Ganghyeok-Lim/Proj-STM32H743VIT6-Test-Dev-Board/Rev_A/03_Document/00_Project/Block Diagram/Block diagram.pptx

DC Barrel Jack

DC/DC Converter
1. P24VS → P5VS
2. P5VS → P3.3VS

SW & KEYPAD

Temperature Sensor
(LM75AD)

IR Sensor
(LTOP-ML38ATH)

STM32H743VIT6
(ARM Cortex-M7)

USB-UART
(CP2102)

EEPROM
AT24C16C

USB C-type

TFT LCD
(TFT-32A)

Character LCD
(OTM 651 Y-YG-1)

Buzzer

ADC
(ADS1100)

DAC
(MCP4725)

Ext. Header

## Slide 2

STM32H743VIT6

DC/DC Converter
1. P24VS → P5VS
2. P5VS → P3.3VS

SW & KEYPAD

CP2102
USB-UART

DC/DC Converters
1. +1V
2. +1.35V
3. +1.8V
4. +3.3V
5. VTT

USB C-type

Page. 5

DC Barrel Jack

Temperature Sensor

Page. 3

ADC

Page. 8,9

Mezzanine

Page. 10

Mezzanine

Page. 10
