Ganghyeok-Lim/Proj-STM32H743VIT6-Test-Dev-Board/Rev_A/01_HW/JLCPCB Fab data/4. Confirmation File/Part placement confirmation Image_240208_2223.png

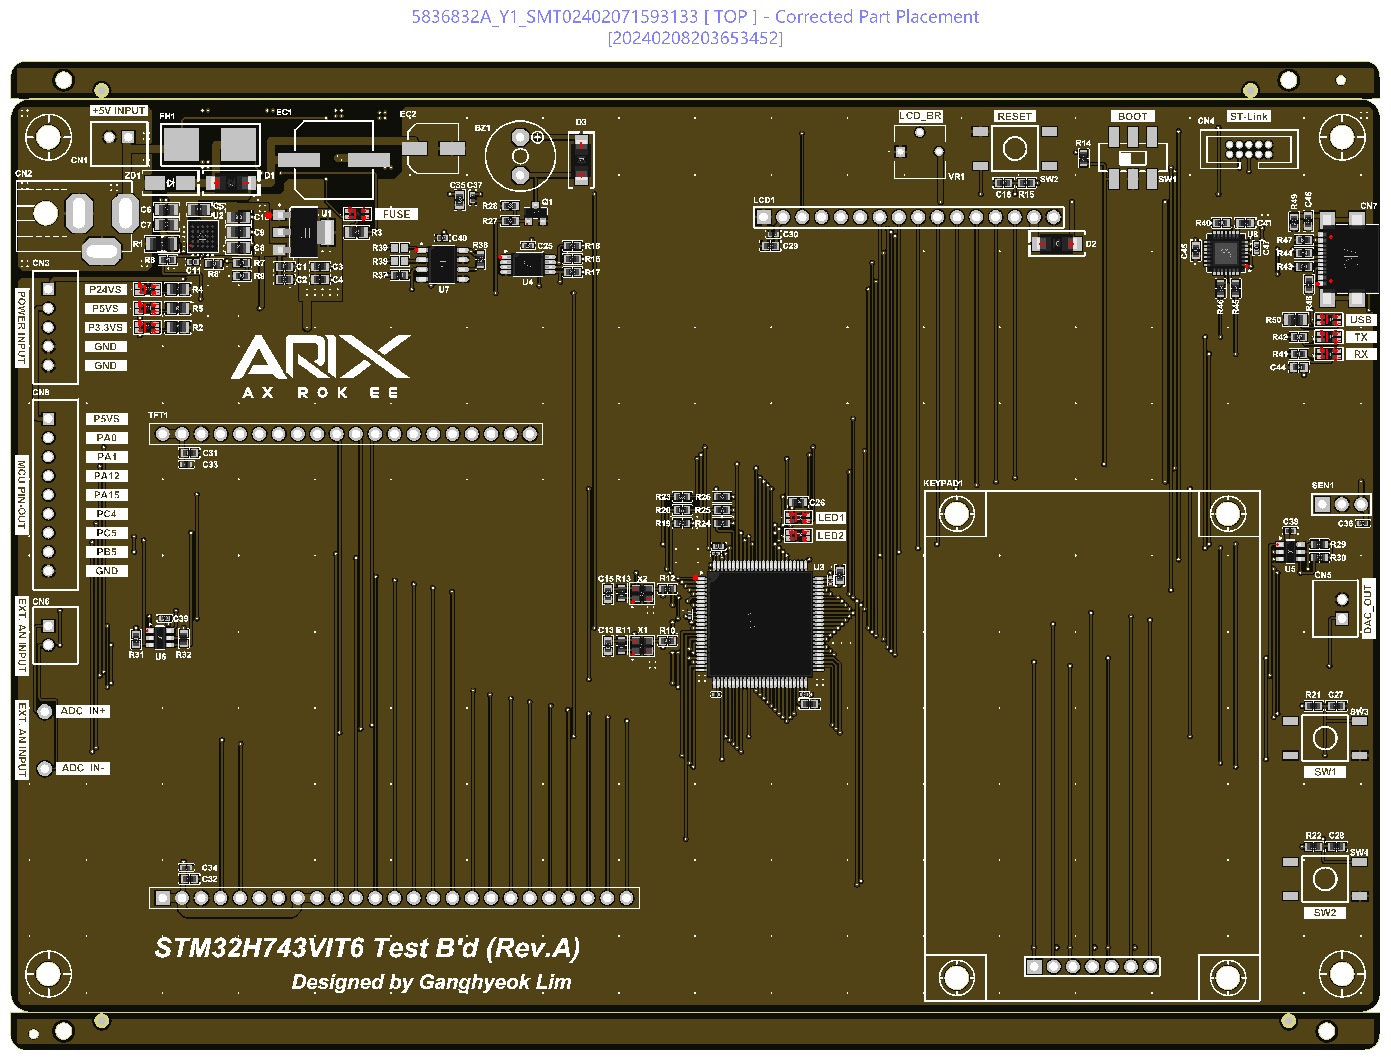
Rev_A/01_HW/JLCPCB Fab data/4. Confirmation File/Part placement confirmation Image_240208_2223.png
