Ganghyeok-Lim/Proj-STM32H743VIT6-Test-Dev-Board/Rev_A/01_HW/JLCPCB Fab data/2. BOM/Bill of Materials-STM32H743VIT6_Test_Bd.xlsx

Comment | Designator | Footprint | Quantity | LCSC Part #
FQ-014 | BZ1 | BUZ FQ-013 | 1
10uF/10V/1608 | C1, C4, C29, C31, C32, C35 | CAP 1608 (0603_INCH) | 6 | C19702
100nF/50V/1608 | C2, C3, C13, C15, C16, C27, C28, C46 | CAP 1608 (0603_INCH) | 8 | C14663
10uF/50V/2012 | C5, C10 | CAP 2012 (0805_INCH) | 2 | C440198
2.2uF/50V/2012 | C6, C9 | CAP 2012 (0805_INCH) | 2 | C49217
100nF/50V/2012 | C7, C8 | CAP 2012 (0805_INCH) | 2 | C49678
100nF/16V/1005 | C11, C25, C30, C33, C34, C36, C37, C38, C39, C40, C47 | CAP 1005 (0402_INCH) | 11 | C1525
15pF/16V/1608/NC | C12, C14, C42, C43 | CAP 1608 (0603_INCH)/NC | 4
4.7uF/10V/1005 | C17 | CAP 1005 (0402_INCH) | 1 | C23733
100nF/25V/0603 | C18, C19, C20, C21, C22 | CAP 0603 (0201_INCH) | 5 | C181047
2.2uF/16V/1608 | C23, C24, C26, C44 | CAP 1608 (0603_INCH) | 4 | C23630
1uF/50V/1608 | C41, C45 | CAP 1608 (0603_INCH) | 2 | C15849
0353120260 | CN1, CN5, CN6 | CON 0353120260 (MOLEX) | 3
DC_Jack | CN2 | CON DC-Jack | 1
0353120560 | CN3 | CON 0353120560 (MOLEX) | 1
3220-10-0100-00 | CN4 | CON 3220-10-0100-00 (Hand_Solder) | 1
MC-311S | CN7 | CON USB-Type-C (16P) | 1 | C2977718
0353120960 | CN8 | CON 0353120960 (MOLEX) | 1
SS34 | D1 | DIO DO-214AC (SMA) | 1 | C8678
M7 | D2, D3 | DIO DO-214AC (SMA) | 2 | C95872
330uF/35V/10Øx10 | EC1 | CAP ALSMD 10.3MM H10.5MM LEADSPANMAX12MM | 1 | C311621
100uF/35V/6.3Øx7.7 | EC2 | CAP ALSMD 6.6MM H7.7MM | 1 | C176666
01550900M | FH1 | FUSE 01550900M_SMD(Hand_Solder) | 1 | C108518
NTH-3MM | H1, H2, H3, H4 | HOLE NTH-3MM | 4
NT-804AN-BW | KEYPAD1 | KEYPAD_NT-804AN-BW | 1
Character_LCD(1602) | LCD1 | LCD_CHARACTOR-1602 | 1
BLUE/2012 | LED1, LED2, LED4, LED7, LED8, LED9 | LED MHT170RGBCT (BLUE) | 6 | C2962094
RED/2012 | LED3 | LED MHT170RGBCT (RED) | 1 | C2962094
RGB/2012 | LED5, LED6 | LED MHT170RGBCT | 2 | C2962094
MMBT3904 | Q1 | SOT 23-3 (DIODES INCORPORATED) | 1 | C20526
0R/3216 | R1 | RES 3216 (1206_inch) | 1 | C17888
330R/2012 | R2 | RES 2012 (0805_inch) | 1 | C17630
4.7K/2012 | R3, R4 | RES 2012 (0805_inch) | 2 | C17673
680R/2012 | R5, R50 | RES 2012 (0805_inch) | 2 | C17798
100K/1608 | R6, R14, R15, R21, R22 | RES 1608 (0603_inch) | 5 | C25803
47K/1608 | R7 | RES 1608 (0603_inch) | 1 | C25819
23.7K/1608 | R8 | RES 1608 (0603_inch) | 1 | C294653
300R/1608 | R9 | RES 1608 (0603_inch) | 1 | C23025
0R/1608 | R10, R11, R12, R13, R36, R43, R44, R45, R46 | RES 1608 (0603_inch) | 9 | C21189
4.7K/1608 | R16, R17, R18, R28, R29, R30, R31, R32, R40 | RES 1608 (0603_inch) | 9 | C23162
470R/1608 | R19, R20, R23, R24, R25, R26 | RES 1608 (0603_inch) | 6 | C23179
1K/1608 | R27 | RES 1608 (0603_inch) | 1 | C21190
4.7K/1608/NC | R33, R34, R35, R38, R39 | RES 1608 (0603_inch)/NC | 5
10K/1608 | R37 | RES 1608 (0603_inch) | 1 | C25804
330R/1608 | R41, R42 | RES 1608 (0603_inch) | 2 | C23138
5.1K/1608 | R47, R48 | RES 1608 (0603_inch) | 2 | C23186
1M/1608/0.1W | R49 | RES 1608 (0603_inch) | 1 | C22935
SB | SB1, SB2, SB3, SB4, SB5, SB6 | SB (Solder-Bridge) | 6
LTOP-ML38ATH | SEN1 | SEN_IR-LTOP-ML38ATH | 1
YSS-1201S(2mm)_2P | SW1 | SW YSS-1201S-2mm | 1
TACT_SW | SW2, SW3, SW4 | SW K2-1102SP-C4SC-04 | 3 | C127509
TFT-32A | TFT1 | LCD_TFT-32A | 1
TP_HOLE(1MM) | TP1, TP2 | TP_HOLE(1MM) | 2
AMS1117-3.3 | U1 | SOT 223-3 (DIODES INCORPORATED) | 1 | C6186
LTM8074IY#PBF | U2 | IC_BGA-25 | 1 | C690772
STM32H743VIT6 | U3 | LQFP-100_14x14MM (ST) | 1 | C114409
AT24C16 | U4 | TSSOP-8_PW (TI) | 1 | C112954
MCP4725A1T-E/CH | U5 | SOT-23-6 (TI DBV PACKAGE) | 1 | C61423
ADS1100A0IDBVR | U6 | SOT-23-6 (TI DBV PACKAGE) | 1 | C23361
LM75AD | U7 | SOIC-8 150mil Wide (MICRO CHIP) | 1 | C7963
CP2102-GMR | U8 | QFN-28 (5x5mm) | 1 | C6568
3362P-1-103LF | VR1 | VR_3362P-1-103LF | 1 | C58159
S2D12.000000B20F30T(12MHz) | X1 | OSC SMD_2.5x2.0 (SCTF) | 1 | C387449
S2D32.768KB20F30T(32.768kHz) | X2 | OSC SMD_2.5x2.0 (SCTF) | 1 | C387463
SMAJ24A | ZD1 | DIO DO-214AC (SMA) | 1 | C113962
