Ganghyeok-Lim/Proj-STM32H743VIT6-Test-Dev-Board/(list of files, drawings)

Other design files:
Rev_A/01_HW/STM32H743VIT6 Test B'd/00_Index.SchDoc
Rev_A/01_HW/STM32H743VIT6 Test B'd/01_Overview.SchDoc
Rev_A/01_HW/STM32H743VIT6 Test B'd/02_Power.SchDoc
Rev_A/01_HW/STM32H743VIT6 Test B'd/03_MCU.SchDoc
Rev_A/01_HW/STM32H743VIT6 Test B'd/04_LCD.SchDoc
Rev_A/01_HW/STM32H743VIT6 Test B'd/05_Sensor_Keypad.SchDoc
Rev_A/01_HW/STM32H743VIT6 Test B'd/06_Communication.SchDoc
Rev_A/01_HW/STM32H743VIT6 Test B'd/STM32H743VIT6 Test B'd.PrjPcb
