Ganghyeok-Lim/Proj-STM32H743VIT6-Test-Dev-Board/Rev_A/02_FW/STM32H743VIT6_Dev_Bd/Core/Src/main.c

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
/* Includes ------------------------------------------------------------------*/
#include "main.h"


TIM_HandleTypeDef htim1;
TIM_HandleTypeDef htim6;

/* USER CODE BEGIN PV */
uint8_t str1[] = "Live like Woong";
uint8_t str2[] = "     by Minjung";

extern uint8_t Keypad_value;
extern uint8_t Keypad_read_enable;
extern uint8_t Keypad_Data[32];
/* USER CODE END PV */

void SystemClock_Config(void);
static void MX_GPIO_Init(void);
static void MX_TIM1_Init(void);
static void MX_TIM6_Init(void);
/* USER CODE BEGIN PFP */
void Delay_us(uint16_t time_us);
/* USER CODE END PFP */

/**
  * @brief  The application entry point.
  * @retval int
  */
int main(void)
{
  /* MCU Configuration--------------------------------------------------------*/

  /* Reset of all peripherals, Initializes the Flash interface and the Systick. */
  HAL_Init();

  /* Configure the system clock */
  SystemClock_Config();

  /* Initialize all configured peripherals */
  MX_GPIO_Init();
  MX_TIM1_Init();
  MX_TIM6_Init();
  /* USER CODE BEGIN 2 */
	HAL_TIM_Base_Start(&htim1);
	HAL_TIM_Base_Start_IT(&htim6);

	HAL_GPIO_WritePin(MCU_KEYPAD_ROW1_GPIO_Port, MCU_KEYPAD_ROW1_Pin, LOW);

	HAL_Delay(10);
	Initialize_LCD();
	HAL_Delay(100);

	memset(Keypad_Data, 0x20, sizeof(Keypad_Data));





  /* USER CODE END 2 */

  /* Infinite loop */
  /* USER CODE BEGIN WHILE */
  while (1)
  {
    /* USER CODE END WHILE */

    /* USER CODE BEGIN 3 */
//	LCD_String(0x80, str1);
//	HAL_Delay(10);
//	LCD_String(0xC0, str2);
//	HAL_Delay(200);

//	LCD_Cursor(1,1);
//	LCD_Data(Keypad_value);
//	HAL_Delay(100);


	  for(int i = 0; i < 32; i++)
	  {
		  if(i < 16)
		  {
			  LCD_Cursor(1,i+1);
			  LCD_Data(Keypad_Data[i]);
			  HAL_Delay(1);
		  }
		  else
		  {
			  LCD_Cursor(2,i-15);
			  LCD_Data(Keypad_Data[i]);
			  HAL_Delay(1);
		  }
	  }

	  HAL_Delay(10);
  }
  /* USER CODE END 3 */
}

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
/* USER CODE BEGIN 4 */
void Delay_us(uint16_t time_us)
{
	__HAL_TIM_SET_COUNTER(&htim1, 0);
	while((__HAL_TIM_GET_COUNTER(&htim1))<time_us);
}

/* USER CODE END 4 */
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
