Ganghyeok-Lim/Proj-STM32H743VIT6-Test-Dev-Board/Rev_A/02_FW/STM32H743VIT6_Dev_Bd/Core/Inc/main.h

#define MCU_TACT_SW1_Pin GPIO_PIN_0
#define MCU_TACT_SW1_GPIO_Port GPIOC
#define MCU_TACT_SW1_EXTI_IRQn EXTI0_IRQn
#define MCU_TACT_SW2_Pin GPIO_PIN_1
#define MCU_TACT_SW2_GPIO_Port GPIOC
#define MCU_TACT_SW2_EXTI_IRQn EXTI1_IRQn
#define MCU_LED1_BLUE_Pin GPIO_PIN_0
#define MCU_LED1_BLUE_GPIO_Port GPIOB
#define MCU_LED1_GREEN_Pin GPIO_PIN_2
#define MCU_LED1_GREEN_GPIO_Port GPIOB
#define MCU_LED2_RED_Pin GPIO_PIN_12
#define MCU_LED2_RED_GPIO_Port GPIOB
#define MCU_CHAR_LCD_RS_Pin GPIO_PIN_8
#define MCU_CHAR_LCD_RS_GPIO_Port GPIOD
#define MCU_CHAR_LCD_RW_Pin GPIO_PIN_9
#define MCU_CHAR_LCD_RW_GPIO_Port GPIOD
#define MCU_CHAR_LCD_E_Pin GPIO_PIN_10
#define MCU_CHAR_LCD_E_GPIO_Port GPIOD
#define MCU_KEYPAD_ROW1_Pin GPIO_PIN_6
#define MCU_KEYPAD_ROW1_GPIO_Port GPIOC
#define MCU_KEYPAD_ROW2_Pin GPIO_PIN_7
#define MCU_KEYPAD_ROW2_GPIO_Port GPIOC
#define MCU_KEYPAD_ROW3_Pin GPIO_PIN_8
#define MCU_KEYPAD_ROW3_GPIO_Port GPIOC
#define MCU_KEYPAD_ROW4_Pin GPIO_PIN_9
#define MCU_KEYPAD_ROW4_GPIO_Port GPIOC
#define MCU_KEYPAD_COL1_Pin GPIO_PIN_10
#define MCU_KEYPAD_COL1_GPIO_Port GPIOC
#define MCU_KEYPAD_COL1_EXTI_IRQn EXTI15_10_IRQn
#define MCU_KEYPAD_COL2_Pin GPIO_PIN_11
#define MCU_KEYPAD_COL2_GPIO_Port GPIOC
#define MCU_KEYPAD_COL2_EXTI_IRQn EXTI15_10_IRQn
#define MCU_KEYPAD_COL3_Pin GPIO_PIN_12
#define MCU_KEYPAD_COL3_GPIO_Port GPIOC
#define MCU_KEYPAD_COL3_EXTI_IRQn EXTI15_10_IRQn
#define MCU_CHAR_LCD_DATA0_Pin GPIO_PIN_0
#define MCU_CHAR_LCD_DATA0_GPIO_Port GPIOD
#define MCU_CHAR_LCD_DATA1_Pin GPIO_PIN_1
#define MCU_CHAR_LCD_DATA1_GPIO_Port GPIOD
#define MCU_CHAR_LCD_DATA2_Pin GPIO_PIN_2
#define MCU_CHAR_LCD_DATA2_GPIO_Port GPIOD
#define MCU_CHAR_LCD_DATA3_Pin GPIO_PIN_3
#define MCU_CHAR_LCD_DATA3_GPIO_Port GPIOD
#define MCU_CHAR_LCD_DATA4_Pin GPIO_PIN_4
#define MCU_CHAR_LCD_DATA4_GPIO_Port GPIOD
#define MCU_CHAR_LCD_DATA5_Pin GPIO_PIN_5
#define MCU_CHAR_LCD_DATA5_GPIO_Port GPIOD
#define MCU_CHAR_LCD_DATA6_Pin GPIO_PIN_6
#define MCU_CHAR_LCD_DATA6_GPIO_Port GPIOD
#define MCU_CHAR_LCD_DATA7_Pin GPIO_PIN_7
#define MCU_CHAR_LCD_DATA7_GPIO_Port GPIOD
#define MCU_LED1_RED_Pin GPIO_PIN_4
#define MCU_LED1_RED_GPIO_Port GPIOB
#define MCU_LED2_BLUE_Pin GPIO_PIN_8
#define MCU_LED2_BLUE_GPIO_Port GPIOB
#define MCU_LED2_GREEN_Pin GPIO_PIN_9
#define MCU_LED2_GREEN_GPIO_Port GPIOB
#define FLAG				uint8_t
#define HIGH                (1U)
#define LOW                 (0U)
#define CLEAR				(0U)
#define ON					(1U)
#define OFF					(0U)
#define LOCK				(0U)
#define RELEASE				(1U)
#define KEY_PRESSED			(0U)
#define KEY_RELEASED		(1U)
#define KEYPAD_ROW1			1
#define KEYPAD_ROW2			2
#define KEYPAD_ROW3			3
#define KEYPAD_ROW4			4
#define KEYPAD_COL1			1
#define KEYPAD_COL2			2
#define KEYPAD_COL3			3
