Ganghyeok-Lim/Proj-STM32H743VIT6-Test-Dev-Board/(commit log)

2024-02-23 [Fix] Removed Git Cache
    [00_Index.SchDoc, 01_Overview.SchDoc, 02_Power.SchDoc, 03_MCU.SchDoc, 04_LCD.SchDoc, 05_Sensor_Keypad.SchDoc, 06_Communication.SchDoc, Bill of Materials-STM32H743VIT6_Test_B'd.xlsx]
2024-02-23 [FW] Add : STM32H743VIT6 FW Project
    STM32H743VIT6 Project is added.
    # Feature
    - Status LED Control FW
    - External Tact SW input FW (by EXTI)
    - LCD Driver Control FW
2024-02-26 [FW] Feat : Add 4by3 Keypad driver code
2024-02-28 [Chore] Change Folder structure
    [00_Index.SchDoc, 01_Overview.SchDoc, 02_Power.SchDoc, 03_MCU.SchDoc, 04_LCD.SchDoc, 05_Sensor_Keypad.SchDoc, 06_Communication.SchDoc, Bill of Materials-STM32H743VIT6_Test_B'd.xlsx]
