Ganghyeok-Lim/Proj-STM32H743VIT6-Test-Dev-Board/(notices)

Notices in the files:
Rev_A/02_FW/STM32H743VIT6_Dev_Bd/Core/Src/main.c:
Copyright (c) 2024 STMicroelectronics.
All rights reserved.
This software is licensed under terms that can be found in the LICENSE file
